TejasQ/headcar/slides/site.png

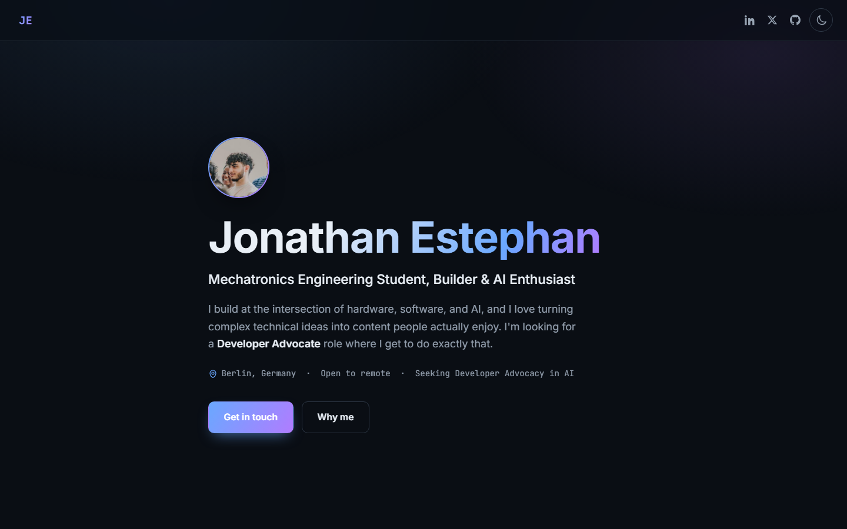
slides/site.png
