TejasQ/headcar/slides/site_full.png

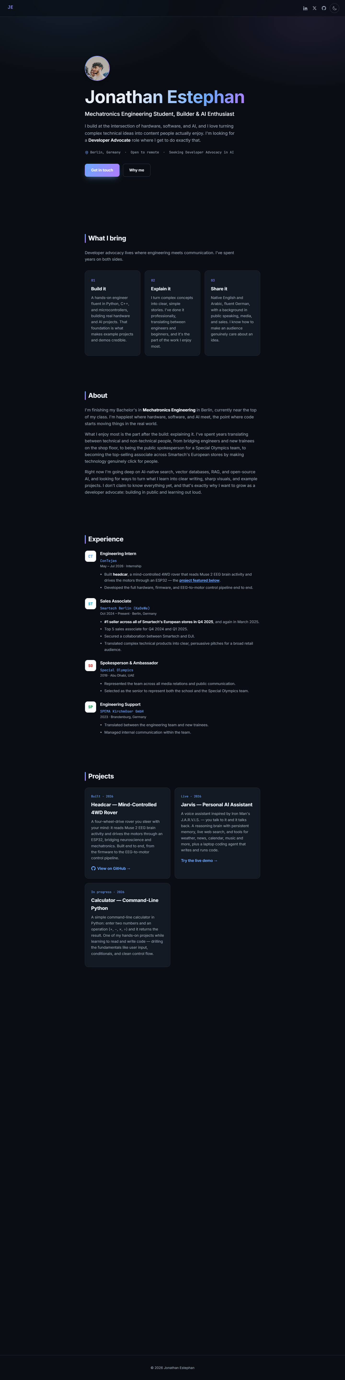
slides/site_full.png
