TejasQ/headcar/(commit log)

2026-05-11 Pivot laptop side to Next.js + Web Bluetooth
    Drop noble/terminal approach; use muse-js over Web Bluetooth in the
    browser. Next.js app scaffolded in laptop/. Deployed to Vercel but
    must be run locally (npm run dev) when driving — HTTPS blocks
    ws://car.local. Also switches car comms from UDP to WebSocket.
2026-05-15 Phase 1 complete: dashboard with simulate mode + Phase 2 ESP32 sketch
    - laptop/: Muse BLE connect, blink/jaw clench/accel display, WebSocket
    client to car, simulate mode (fake blink every 3s, clench every 7s,
    sine-wave accel) so the full pipeline is testable before Muse arrives
    - car/: WiFi, mDNS (car.local), WebSocket server port 81, TB6612 motor
    control; GPIO corrected (AIN2=18, PWMB=19 — pins 6/7 are flash-only)
    - README/CLAUDE.md: pin table corrected, phase status updated
    [car.ino]
2026-05-18 Progress save: Muse arrived, Phase 2 wiring partially done
    - Muse 2 arrived
    - TB6612 wiring done except motors: power, GND, VCC, STBY, 6 signal wires
    - Blocked: loose female connectors on TB6612 pins, buck needs soldering
    - Plan: xHain makerspace for soldering, or pivot to Muse hello world next
    - thesis.md: journal entry added for 2026-05-18
    - SUMMARY.md: phase 2 status and shopping list updated
2026-05-19 Phase 1 confirmed: Muse 2 live data working in browser
    Blink, jaw clench, and accelerometer all verified with real hardware.
    Full signal chain from Muse 2 to browser dashboard confirmed.
2026-05-20 Phase 3 sketch + dashboard: reverse, manual controls, configurable URL
    car/car.ino:
    - Parse WebSocket payload: blink=forward, clench=reverse, stop=coast
    - Add driveReverse() function
    laptop/app/page.tsx:
    - Car URL now editable via text input (no more hardcoded IP)
    - Manual Forward/Reverse/Stop buttons for hardware testing
    - Buttons disabled when car not connected
    [car.ino]
2026-05-20 Progress save: Phase 2 hardware blocked on soldering, software complete
    All signal-level wiring verified correct via multimeter. Motor not
    spinning due to unreliable bare terminal connection — needs soldering
    at xHain. Phase 3 sketch and dashboard improvements committed.
2026-05-20 Phase 4 software complete: steering, streaming, threshold sliders
    - Refactor from blocking delay() to millis() state machine
    - Add steer:X command (-1.0 to +1.0), differential PWM on left/right
    - DriveState enum: IDLE/FORWARD/REVERSE applied every loop()
    - Stream steer:X every 100ms when car connected (silent, no log spam)
    - accelRef tracks latest accel without stale closure in interval
    - Blink/clench thresholds now live-adjustable via sliders
    - Head Tilt card shows streaming status when car connected
    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
    [car.ino]
2026-05-20 Progress save: xHain plan, mounting layout, pre-visit checklist
    - SUMMARY.md: mounting plan for chassis top plate added
    - thesis.md: journal entry for xHain visit plan and untethered power architecture
2026-05-25 Dashboard: fix stale thresholds, add calibration, dead zone, persistence
    - blinkThresholdRef / clenchThresholdRef mirror slider state so EEG
    subscription always uses the current threshold, not the value at
    connect time
    - Calibrate button snapshots accel.x as the steering zero reference;
    offset stored in accelOffsetRef for use in the streaming interval
    - Dead zone (±0.1) applied to steer value before sending — prevents
    constant micro-corrections when head is roughly straight
    - Threshold sliders persist to localStorage and reload on mount
    - SUMMARY.md updated with full 2026-05-22 debug findings
2026-05-25 Dashboard: add live EEG signal meters per channel
    Four vertical bars (TP9, AF7, AF8, TP10) show peak amplitude in
    real-time at ~20Hz. Dashed yellow line marks blink threshold on
    AF7/AF8; dashed red marks clench threshold on all channels. Bars
    turn yellow above blink threshold and red above clench threshold.
    Makes it easy to set thresholds against actual signal levels.
2026-05-25 Phase 4 signal quality: smoothness filter, mutual exclusion, EEG meters
    - EMG smoothness filter on blink: rejects forehead/eyebrow muscle noise by
    checking hfRms/peak ratio within each 12-sample packet (< 0.4 = smooth EOG)
    - Mutual exclusion: blink suppressed 500ms after any jaw clench fires
    - Rising edge detection for blink: one event per threshold crossing
    - Multi-channel consensus for clench: 3+ of 4 channels within 150ms
    - Cooldowns: 500ms blink, 1000ms clench
    - Live EEG signal meters (4 channels, EMA a=0.2, threshold reference lines)
    - Head tilt calibration + dead zone + adjusted display
    - Threshold sliders persist to localStorage
    - SUMMARY.md and thesis.md updated with all findings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
2026-05-27 Recording + validation pipeline; TP-primary detection rule
    Major iteration on the laptop-side detection pipeline plus a new
    tooling layer for offline evaluation.
    Detection rule:
    - Forward (clench) → TP-primary: tpHigh > tpThr_fwd AND AF/TP ratio
    < 1.6. Empirical data on this hardware showed masseter EMG lands
    almost entirely on TP9/TP10 and barely on AF, contradicting the
    laboratory EMG-on-EEG literature. AF threshold removed from
    the forward rule.
    - Reverse (eyebrow) → AF + ratio > 1.6.
    - EMA smoothing (alpha=0.3) on grouped channel means + 3-tick
    (150 ms) debounce.
    Wire protocol:
    - Replaced discrete blink/clench commands with continuous drive:X
    where X is in [-1, 1]; magn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
    [car.ino]
2026-06-01 Y-axis steering fix, eyebrow ratio retune, agile cadence on Linear
    Code:
    - page.tsx/replayer.ts: steer off accel-Y instead of X (recorded protocol
    showed head-roll lands on Y for this Muse mounting; X barely moves)
    - Lower CLENCH_MAX/EYEBROW_MIN AF/TP ratio cutoff 1.6 -> 1.3 to match
    the empirical clench-eyebrow gap (clenches cap at ~0.6, eyebrows sit
    at ~1.5-1.9 on this hardware)
    - Drop default reverse sensitivity 4.0 -> 3.0 (60% hit rate plateau,
    0 false positives down to 2.0); bump persisted key v5 -> v6 so the
    new default actually takes effect
    Docs:
    - CLAUDE.md: Linear-via-MCP workflow as the authoritative work queue;
    no active-sprint issue may sit in Backlog; Fibonacci + T-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
2026-06-09 Thesis: academic framework restructure per supervisor feedback
    Add formal front matter: general + specific objectives (SO1-SO8),
    10 research questions (graded phrasing, evidence-annotated), 2 hypotheses,
    a statistical/mathematical model, innovation & novelty, 4-part document
    structure, and a Mendeley referencing note. Refresh abstract (Y-axis
    steering, TP-primary clench). Log 2026-06-09 supervisor meeting.
2026-06-09 Docs: study-guide comments + code-learning mode in CLAUDE.md
    Annotate car/car.ino and laptop/app/detector.ts with plain-English
    explanatory comments (comments only, no logic change) as a learning aid.
    Add a Code-learning mode section to CLAUDE.md capturing explanation style,
    annotated files, reading order, and the drive: trace exercise so the
    workflow resumes cleanly across chats.
2026-06-18 Docs: reconcile README/CLAUDE/thesis with as-built system (HEA-22)
    HEA-22 drift cleanup — fix stale facts and dangling cross-refs against the
    actual source (laptop/app/page.tsx, car/car.ino):
    - AF/TP ratio single-cutoff -> dead band (fwd <0.6, rev >1.0)
    - forward debounce 3/150ms -> 5/250ms; intensity map [1,3] -> [1,2]
    - reverse "discrete 800ms pulse" -> held-while-raised
    - sensitivity 2-8x/default 4x/keys .v4 -> 1-8x, defaults 1.2x/3x, keys .v7/.v6
    - meter legend de-staled; deprecated single Headcar project -> Build/Presentation
    - CLAUDE gesture mapping (forward TP-primary, reverse held) now matches README
    - thesis 4.4 TB6612 anchor cites both 2026-05-22 and 2026-06-15 headings
    Also lan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
2026-06-18 Docs: sync thesis as-built sections with detection constants (HEA-22)
    Second pass after verification caught stale facts beyond README/CLAUDE,
    in thesis sections that describe the *current* system (not journal history):
    - Chapter 3 (impl spec): ratio dead band, 5-tick/250ms debounce, held reverse,
    signed per-side steering mix (STEER_DIFFERENTIAL 0.35 -> 1.0)
    - Conceptual mathematical model: r* single-split -> dead band r_fwd/r_rev;
    reverse pulse/cooldown -> held
    - Abstract: "discrete reverse pulses" -> held while raised
    - Research questions RQ3/RQ4/RQ5/RQ7/RQ9: ratio cutoff 1.3 -> dead band,
    3-tick -> 5-tick, forward default 2x -> 1.2x, reverse pulse -> held
    Dated journal entries left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
2026-06-18 Docs: Sprint-2 bench run-sheets, incl. combined HEA-16 + HEA-17 session
    Operational checklists for the hands-on Sprint-2 issues. Adds the combined
    live-drive + battery-drain run-sheet: one setup / one continuous drive where
    HEA-16 (>=2 min recorded live drive) is captured in the first few minutes and
    HEA-17 (drain-to-cutoff runtime) is the same drive continued to cutoff.
2026-06-19 Feat: endurance/battery-drain test button + on-screen timer (HEA-17)
    Adds a dashboard "Run endlessly" toggle that drives the car at a steady 0.6
    (resending every 200ms to beat the 500ms watchdog) with no auto-stop, plus a
    live M:SS timer that freezes at the final runtime on stop or on car cutoff
    (link drop). Disarms Muse control and the streaming loop yields to it so
    nothing fights the steady command. Used to run the HEA-17 drain hands-free.
    Also lands the previously-uncommitted Sprint-2 live-tuning code that was
    sitting in page.tsx (HEA-18/19/21 detection / steering / safety work) — it
    could not be split from the new button without interactive staging.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
2026-06-19 Data: HEA-16 live-drive recordings for Chapter 4
    Two Muse-driven closed-loop drive captures (2026-06-19):
    - headcar-2026-06-19_08-41-45.json — 127.9s qualifying run (>=2 min), all
    gestures exercised, no watchdog/disconnect events
    - headcar-2026-06-19_08-32-58.json — earlier 82s run (under the 2-min bar)
    Kept per the never-discard-recordings rule.
2026-06-19 Docs: HEA-16/17 results — thesis journal entry + script live figures
    - thesis.md: 2026-06-19 journal entry covering the 127.9s live closed-loop
    drive (RQ1), the jaw-fatigue/effort finding (RQ4), the stale-sensitivity
    stutter (RQ5), and the >11.5min battery runtime — Build path now complete.
    - PRESENTATION_SCRIPT.md: resolved the [live-pending] markers with the captured
    figures (live drive done, runtime measured); first commit of the script.
2026-06-19 Firmware + wiring: commit the as-built car (HEA-18/19/20)
    - car/car.ino: as-built ESP32 firmware — L298N pin mapping (PWMA→ENA etc.),
    signed per-side steering mix with STEER_DIFFERENTIAL=1.0 / MOTOR_TRIM=0.0,
    500ms drive watchdog. Backs the steering (HEA-18) and watchdog (HEA-19) work.
    - SUMMARY.md: wiring/pinout brought in line with the built car (HEA-20).
    These were validated on the real car but had been sitting uncommitted.
2026-06-30 Meetup: talk scripts + slide deck for the Berlin AI meetup
    - MEETUP_TALK.md / _v2 / _v3 — talk drafts (v3 is the locked script)
    - DEMO_CHECKLIST.md — live-demo run-sheet
    - slides/ — self-contained HTML deck: 8 slides, QR to the site, scrolling-site
    close, real fire video (Mixkit, free) composited on the LIVE slide
